jmccall32/Expression-pedal/Oxygen 61 - Vb3m MIDI mapping.xlsx

Keyboard designator | Other marking | Type | Location | VB3m function | MIDI message type | MIDI message number
C10 | - | Rotary pot | Upper right, bottom row | Volume | CC | 7
C11 | - | Rotary pot | Upper right, bottom row | Drive | CC | 76
C12 | - | Rotary pot | Upper right, bottom row | Reverb | CC | 91
C13 | - | Rotary pot | Upper right, bottom row | KeyClick | CC | 75
C14 | - | Rotary pot | Upper right, upper row | Bass | CC | 8
C15 | - | Rotary pot | Upper right, upper row | Treble | CC | 10
C16 | - | Rotary pot | Upper right, upper row | Mic Distance | CC | 93
C17 | - | Rotary pot | Upper right, upper row | Mic Balance | CC | 90
C18 | Pitch bend | Modulation wheel | Left of keyboard
C19 | Modulation | Modulation wheel | Left of keyboard | Rotary Lever | CC | 1
C20 | - | Tactile button | Above keyboard, below F1 | Program 17 | Program | 16
C21 | - | Tactile button | Above keyboard, below F2 | Program 18 | Program | 17
C22 | - | Tactile button | Above keyboard, below F3 | Program 19 | Program | 18
C23 | - | Tactile button | Above keyboard, below F4 | Program 20 | Program | 19
C24 | - | Tactile button | Above keyboard, below F5 | Program 21 | Program | 20
C25 | - | Tactile button | Above keyboard, below F6 | Program 22 | Program | 21
C26 | - | Tactile button | Above keyboard, below F7 | Program 23 | Program | 22
C27 | - | Tactile button | Above keyboard, below F8 | Program 24 | Program | 23
C28 | - | Tactile button | Above keyboard, below F9 | Program 25 | Program | 24
C29 | ⟳ (repeat) | Tactile button | Upper right
C30 | ◀◀ (rewind) | Tactile button | Upper right
C31 | ▶▶ (ff) | Tactile button | Upper right
C32 | ■ (stop) | Tactile button | Upper right
C33 | ▶ (play) | Tactile button | Upper right
C34 | ● (record) | Tactile button | Upper right
C35 | Sustain | 1/4" TR jack | Back | Rotary Speed Switch | CC | 64
F1 | - | Fader | Above keyboard, above C20 | Drawbar Upper 1 | CC | 12
F2 | - | Fader | Above keyboard, above C21 | Drawbar Upper 2 | CC | 13
F3 | - | Fader | Above keyboard, above C22 | Drawbar Upper 3 | CC | 14
F4 | - | Fader | Above keyboard, above C23 | Drawbar Upper 4 | CC | 15
F5 | - | Fader | Above keyboard, above C24 | Drawbar Upper 5 | CC | 16
F6 | - | Fader | Above keyboard, above C25 | Drawbar Upper 6 | CC | 17
F7 | - | Fader | Above keyboard, above C26 | Drawbar Upper 7 | CC | 18
F8 | - | Fader | Above keyboard, above C27 | Drawbar Upper 8 | CC | 19
F9 | - | Fader | Above keyboard, above C28 | Drawbar Upper 9 | CC | 20
 |  |  |  | Vibrato Upper | CC | 31
 |  |  |  | Vibrato Lower | CC | 30
 |  |  |  | Vibrato Select | CC | 73
 |  |  |  | Percussion On | CC | 66
 |  |  |  | Percussion Vol | CC | 70
 |  |  |  | Percussion Dec | CC | 71
 |  |  |  | Percussion Hrm | CC | 72
 |  |  |  | Swell Pedal | CC | 11
 |  |  |  | Drawbar Lower 1 | CC | 21
 |  |  |  | Drawbar Lower 2 | CC | 22
 |  |  |  | Drawbar Lower 3 | CC | 23
 |  |  |  | Drawbar Lower 4 | CC | 24
 |  |  |  | Drawbar Lower 5 | CC | 25
 |  |  |  | Drawbar Lower 6 | CC | 26
 |  |  |  | Drawbar Lower 7 | CC | 27
 |  |  |  | Drawbar Lower 8 | CC | 28
 |  |  |  | Drawbar Lower 9 | CC | 29
 |  |  |  | Drawbar Pedal 1 | CC | 33
 |  |  |  | Drawbar Pedal 2 | CC | 35
 |  |  |  | Amp Select | CC | 85
 |  |  |  | Split On | CC | OFF
 |  |  |  | Split Point | CC | OFF
 |  |  |  | Pedal to Lower | CC | OFF
 |  |  |  | Pedal Decay | CC | 56
 |  |  |  | Program 1 | Program change | 0
 |  |  |  | Program 2 | Program change | 1
 |  |  |  | Program 3 | Program change | 2
 |  |  |  | Program 4 | Program change | 3
 |  |  |  | Program 5 | Program change | 4
 |  |  |  | Program 6 | Program change | 5
 |  |  |  | Program 7 | Program change | 6
 |  |  |  | Program 8 | Program change | 7
 |  |  |  | Program 9 | Program change | 8
 |  |  |  | Program 10 | Program change | 9
 |  |  |  | Program 11 | Program change | 10
 |  |  |  | Program 12 | Program change | 11
 |  |  |  | Program 13 | Program change | 12
 |  |  |  | Program 14 | Program change | 13
 |  |  |  | Program 15 | Program change | 14
 |  |  |  | Program 16 | Program change | 15
 |  |  |  | Program 26 | Program change | 25
 |  |  |  | Program 27 | Program change | 26
 |  |  |  | Program 28 | Program change | 27
 |  |  |  | Program 29 | Program change | 28
 |  |  |  | Program 30 | Program change | 29
 |  |  |  | Program 31 | Program change | 30
 |  |  |  | Program 32 | Program change | 31
