jmccall32/Expression-pedal/MIDI swell pedal schematic.pdf

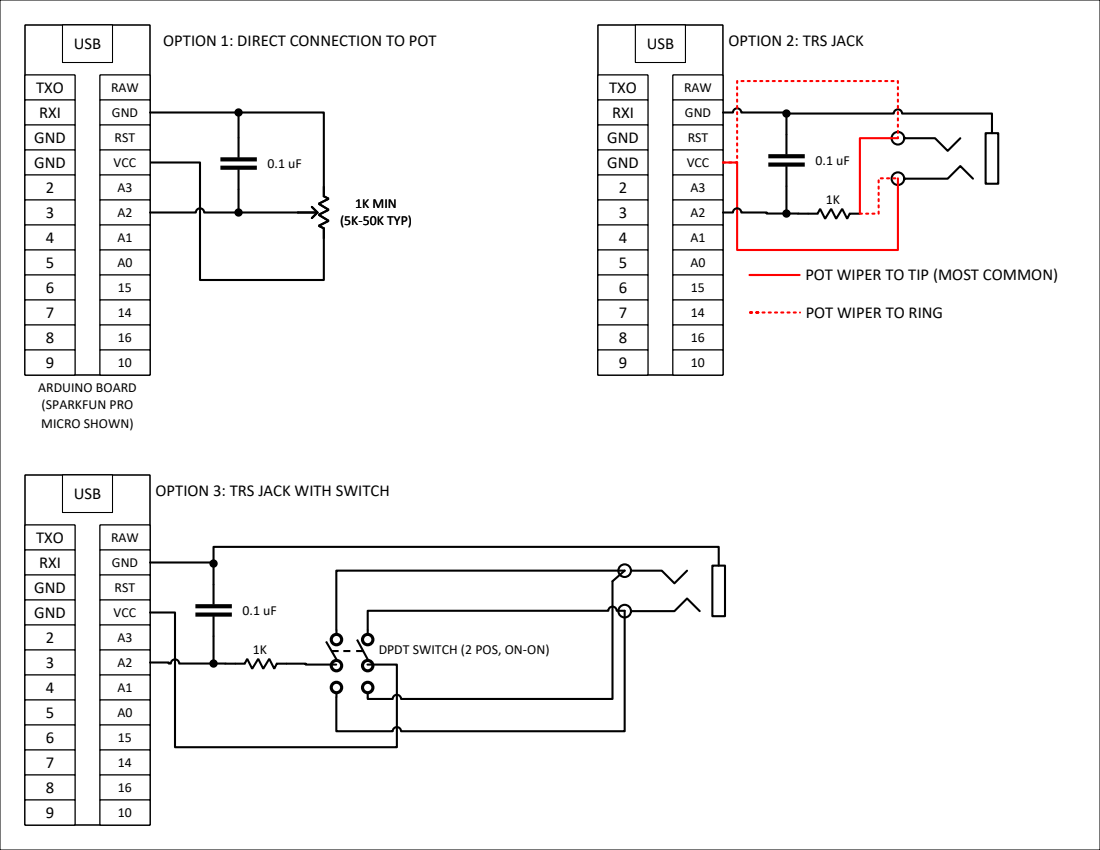
[picture p1: page 1]
ARDUINO BOARD (SPARKFUN PRO MICRO SHOWN); 1K 1K MIN; (5K-50K TYP); RAW; GND; RST; VCC; TXO; RXI; USB; RXI GND

OPTION 1: DIRECT CONNECTION TO POT

OPTION 2: TRS JACK

POT WIPER TO TIP (MOST COMMON)

POT WIPER TO RING

OPTION 3: TRS JACK WITH SWITCH

DPDT SWITCH (2 POS, ON-ON)
