jmccall32/Expression-pedal/(commit log)

2024-03-07 Added better notes on wiring to README.md and added a schematic
2024-03-14 Added Oxygen 61 - Vb3m MIDI mapping.xlsx
    [Oxygen 61 - Vb3m MIDI mapping.xlsx]
2024-07-11 Separated functions for linear & log taper pots
    [Oxygen 61 - Vb3m MIDI mapping.xlsx]
2025-10-20 made cycleEndTime 64 bits
    Avoids potential bad behavior on overflow if pedal is powered for 2^32 milliseconds (~1 month)
    [MIDI_swell_pedal.ino]
